vmalarczyk/airfoil_pcb/brass_manifold.STEP

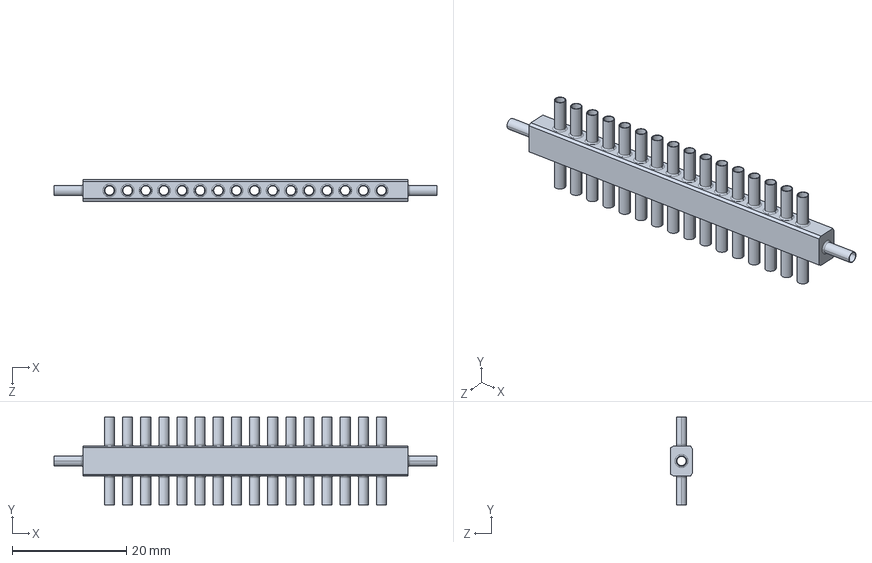
[picture p1: CAD file, 2024-07-12]
brass_manifold.STEP
67.1 x 15.4 x 3.81 mm
