vmalarczyk/airfoil_pcb/connector_component.STEP

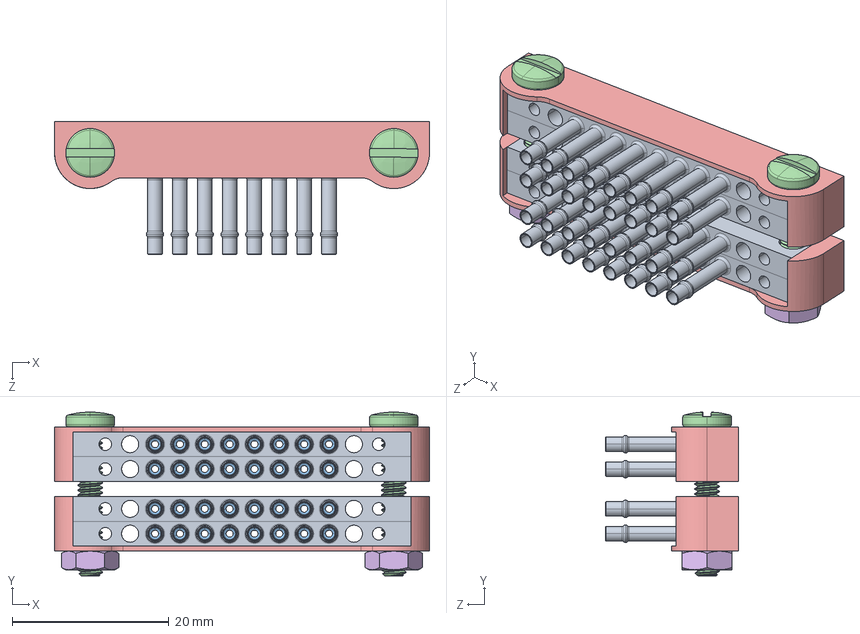
[picture p2: CAD file, 2024-07-12]
connector_component.STEP
47.9 x 20.9 x 16.9 mm
pneumatic_connector x 4
gasket_frame x 4
o_ring x 32
91792A131_18-8 Stainless Steel Pan Head Slotted Screws_91792A131 x 2
connector_holder x 2
90760A130_Steel Narrow Hex Nuts_90760A130 x 2
