vmalarczyk/airfoil_pcb/brass_manifold.pdf

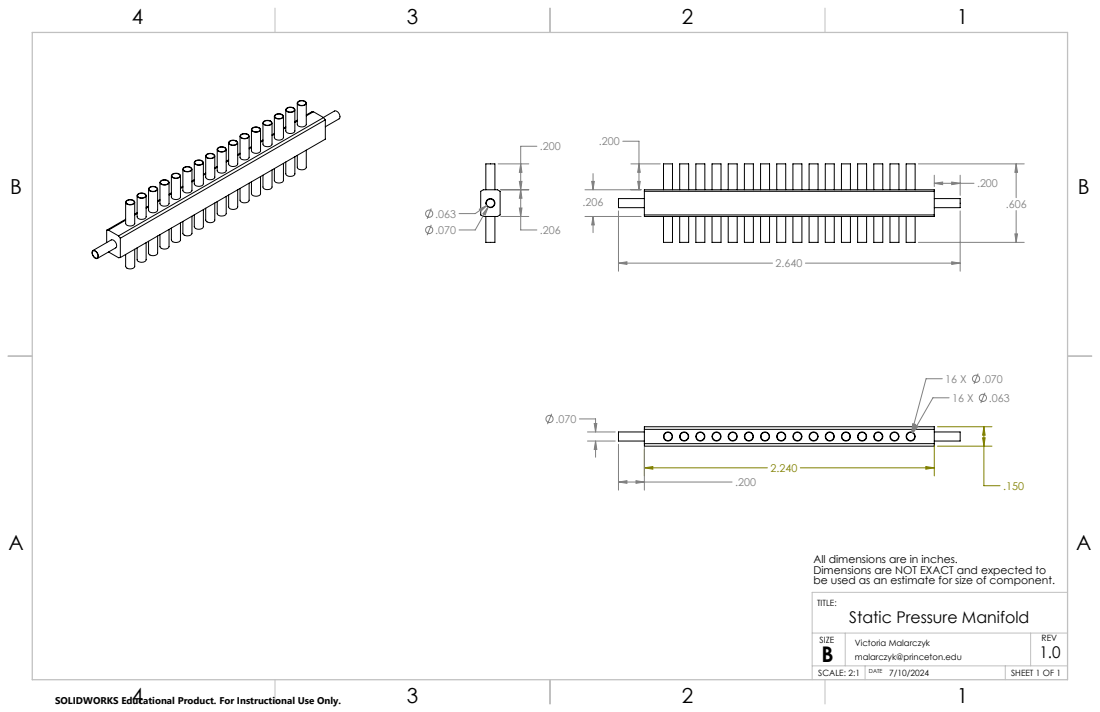
[picture p3: page 1]

All dimensions are in inches.
Dimensions are NOT EXACT and expected to
be used as an estimate for size of component.
Static Pressure Manifold

SIZE B | Victoria Malarczyk malarczyk@princeton.edu | REV 1.0

SCALE: 2:1 | DATE 7/10/2024 | SHEET 1 OF 1

SOLIDWORKS Educational Product. For Instructional Use Only.
