vmalarczyk/airfoil_pcb/tube_connector.pdf

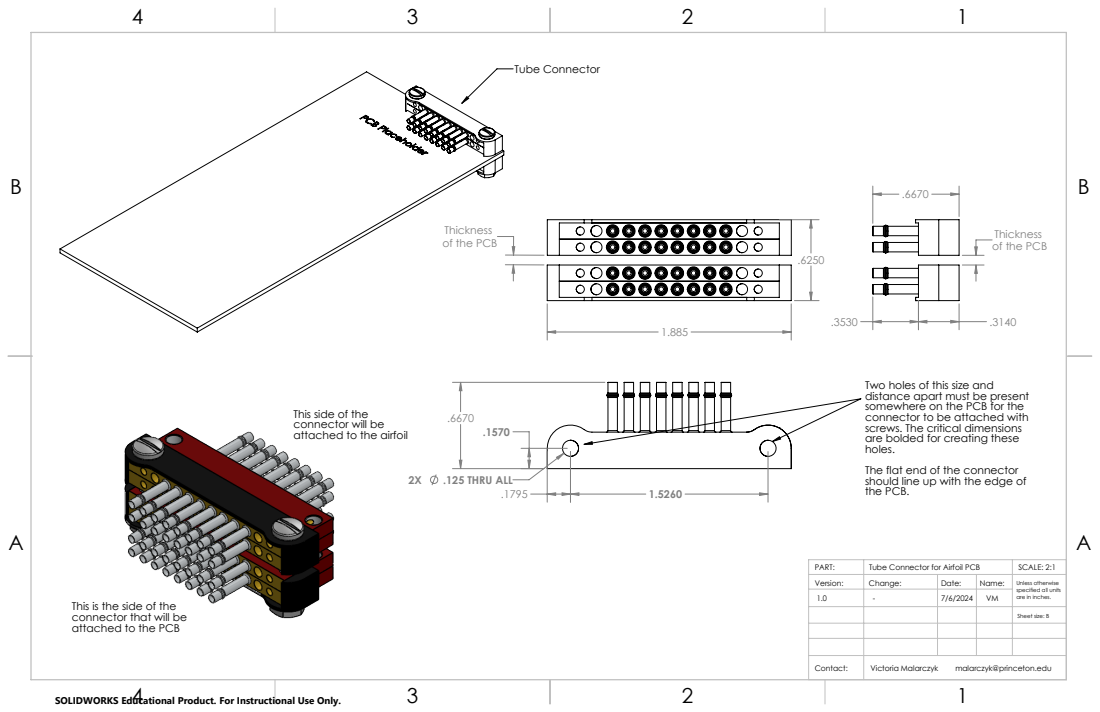
[picture p4: page 1]
Tube Connector; .125 THRU ALL; Contact:; Victoria Malarczyk; malarczyk@princeton.edu

Thickness
of the PCB

Two holes of this size and
distance apart must be present
somewhere on the PCB for the
connector to be attached with
screws. The critical dimensions
are bolded for creating these
holes.
The flat end of the connector
should line up with the edge of
the PCB.

This side of the
connector will be
attached to the airfoil

PART: | Tube Connector for Airfoil PCB | SCALE: 2:1

Version: | Change: | Date: | Name: | Unless otherwise specified all units are in inches.
1.0 | - | 7/6/2024 | VM

This is the side of the
connector that will be
attached to the PCB

Sheet size: B

SOLIDWORKS Educational Product. For Instructional Use Only.
