vmalarczyk/airfoil_pcb/air_foil_pcb/air_foil_pcb.pdf

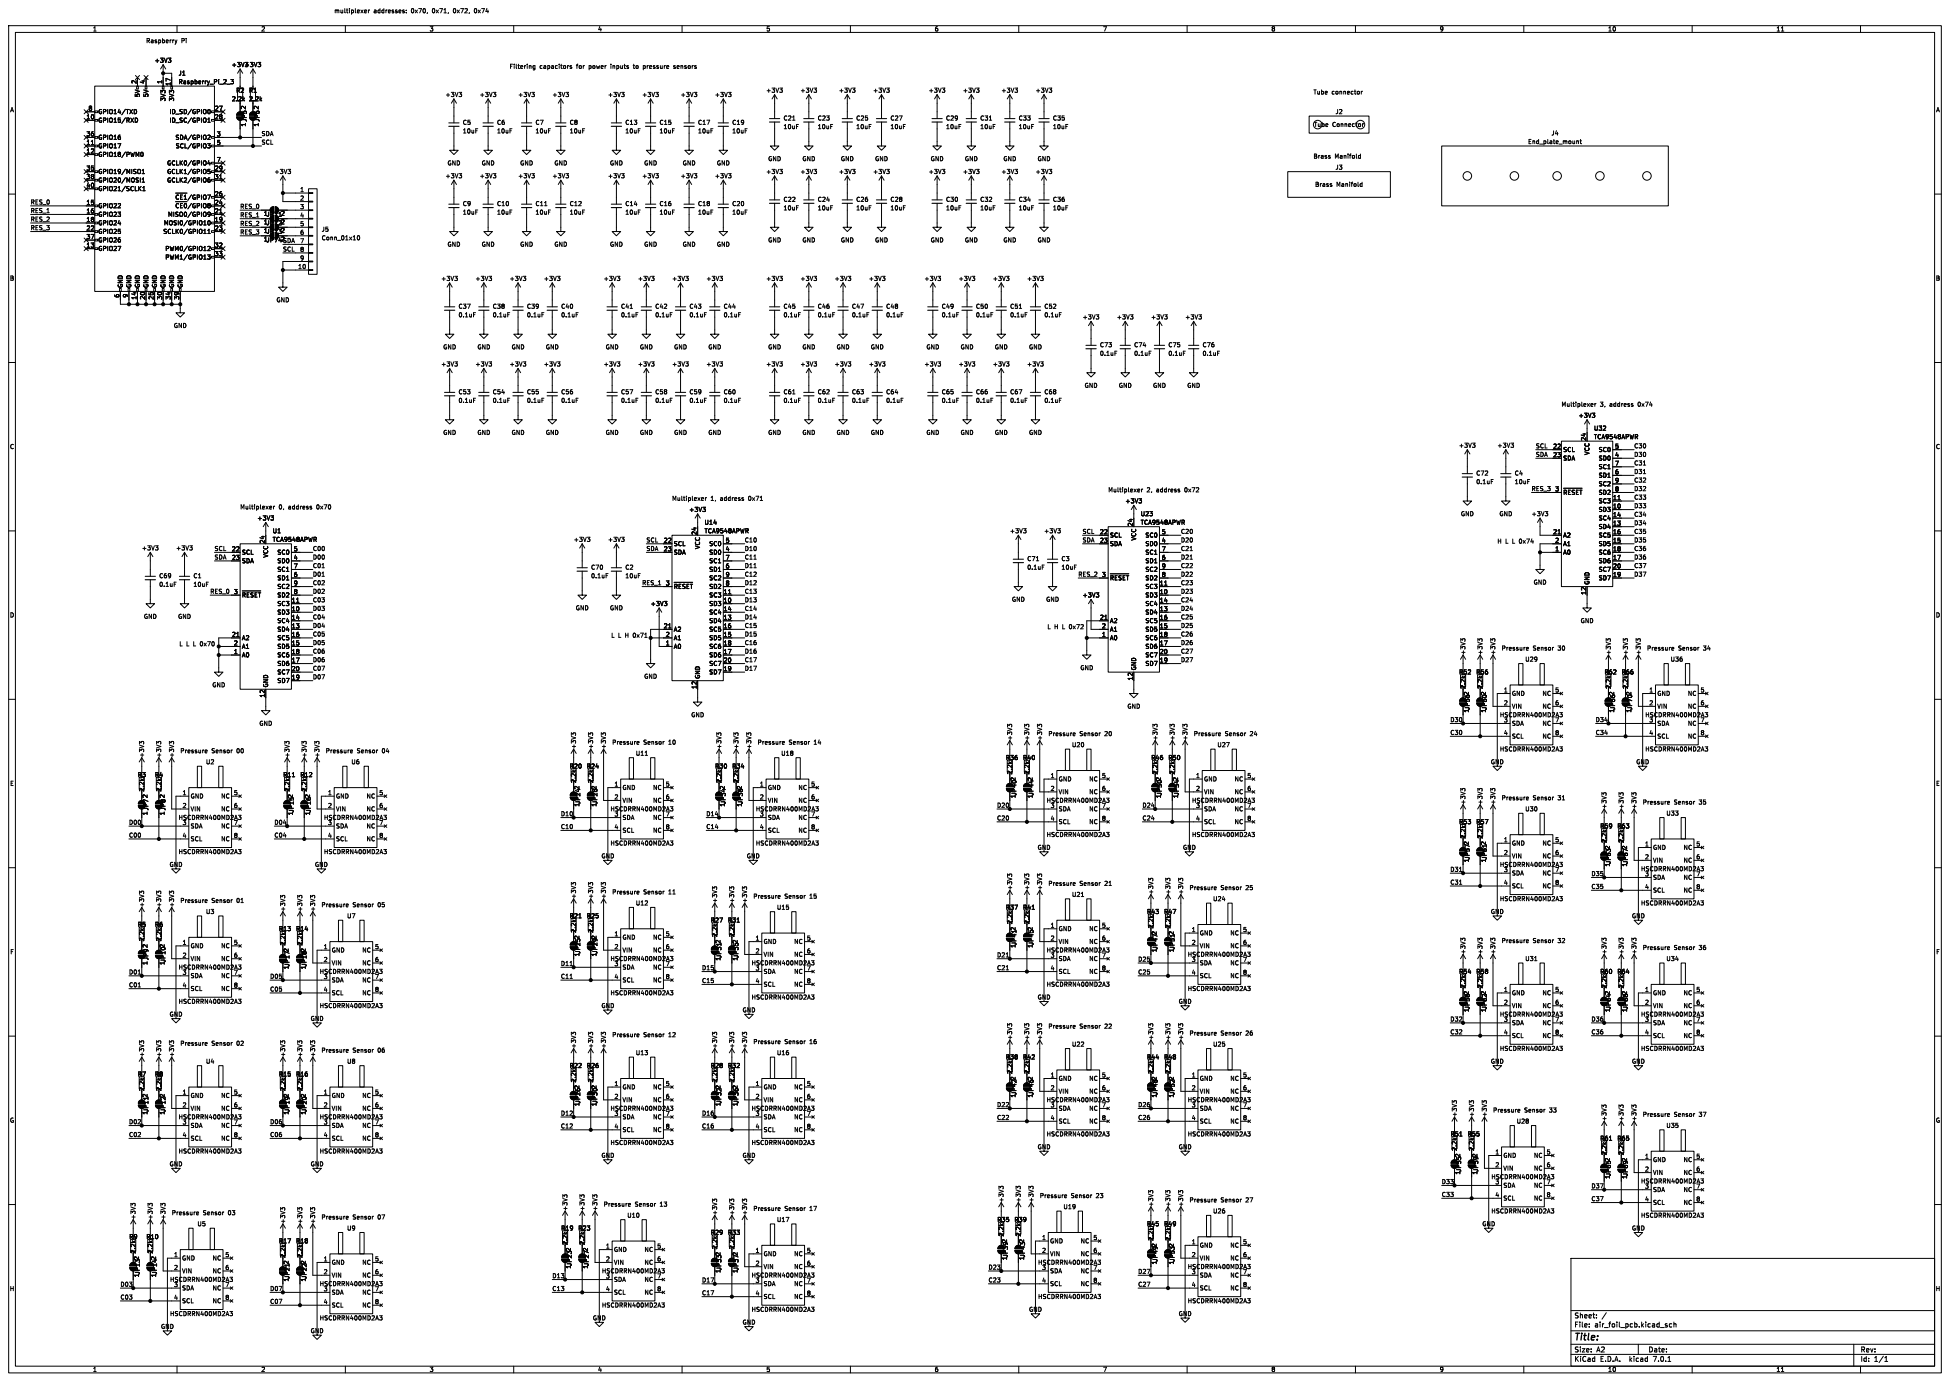
[picture p5: page 1]

+3V3 GND
Pressure Sensor 24 Pressure Sensor 25 Pressure Sensor 23

Pressure Sensor 00 Pressure Sensor 01 Pressure Sensor 02

Pressure Sensor 05 Pressure Sensor 07

Id: 1/1 Title: File: air_foil_pcb.kicad_sch Sheet: /
