vmalarczyk/airfoil_pcb/air_foil_schematic_0_1.pdf

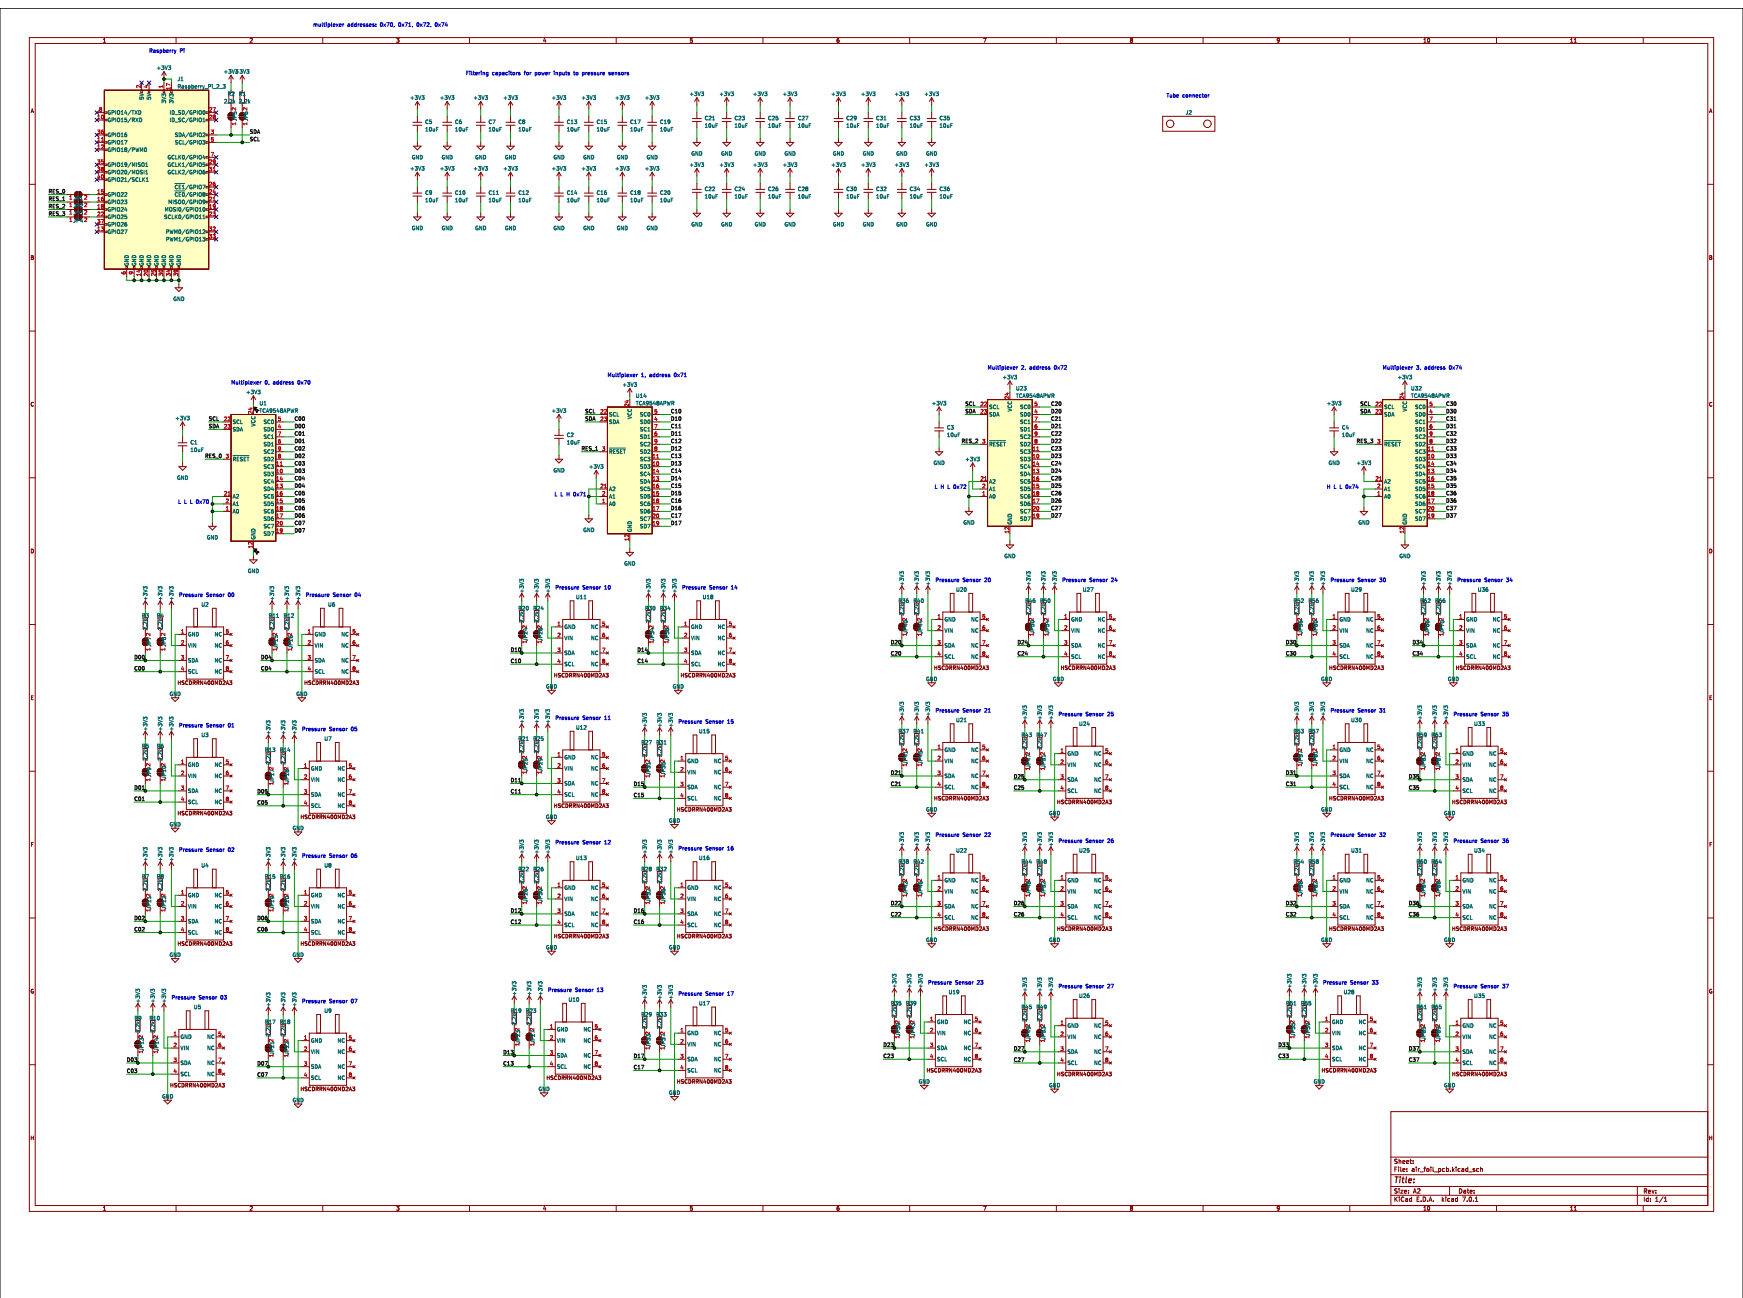
[picture p6: page 1]
