vmalarczyk/airfoil_pcb/air_foil_pcb/air_foil_pcb.kicad_pcb

## KiCad design air_foil_pcb/air_foil_pcb.kicad_pcb (2024-07-13)

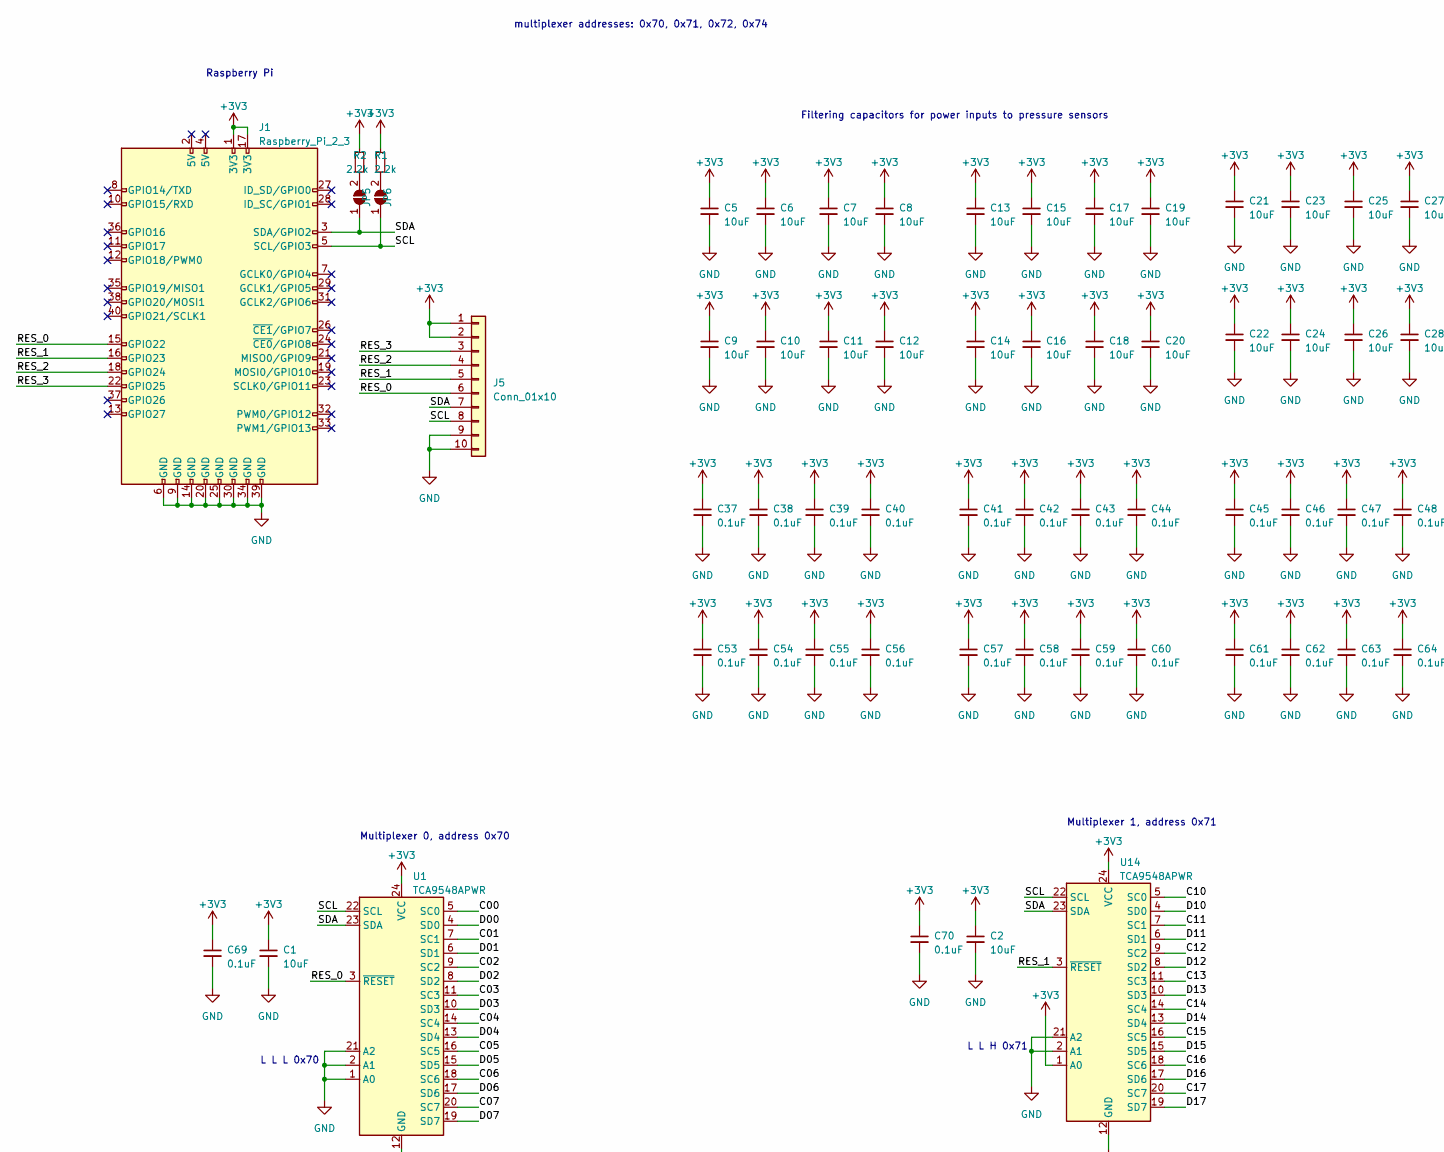
[picture p7: schematic air_foil_pcb.kicad_sch, part in row 1, column 1]

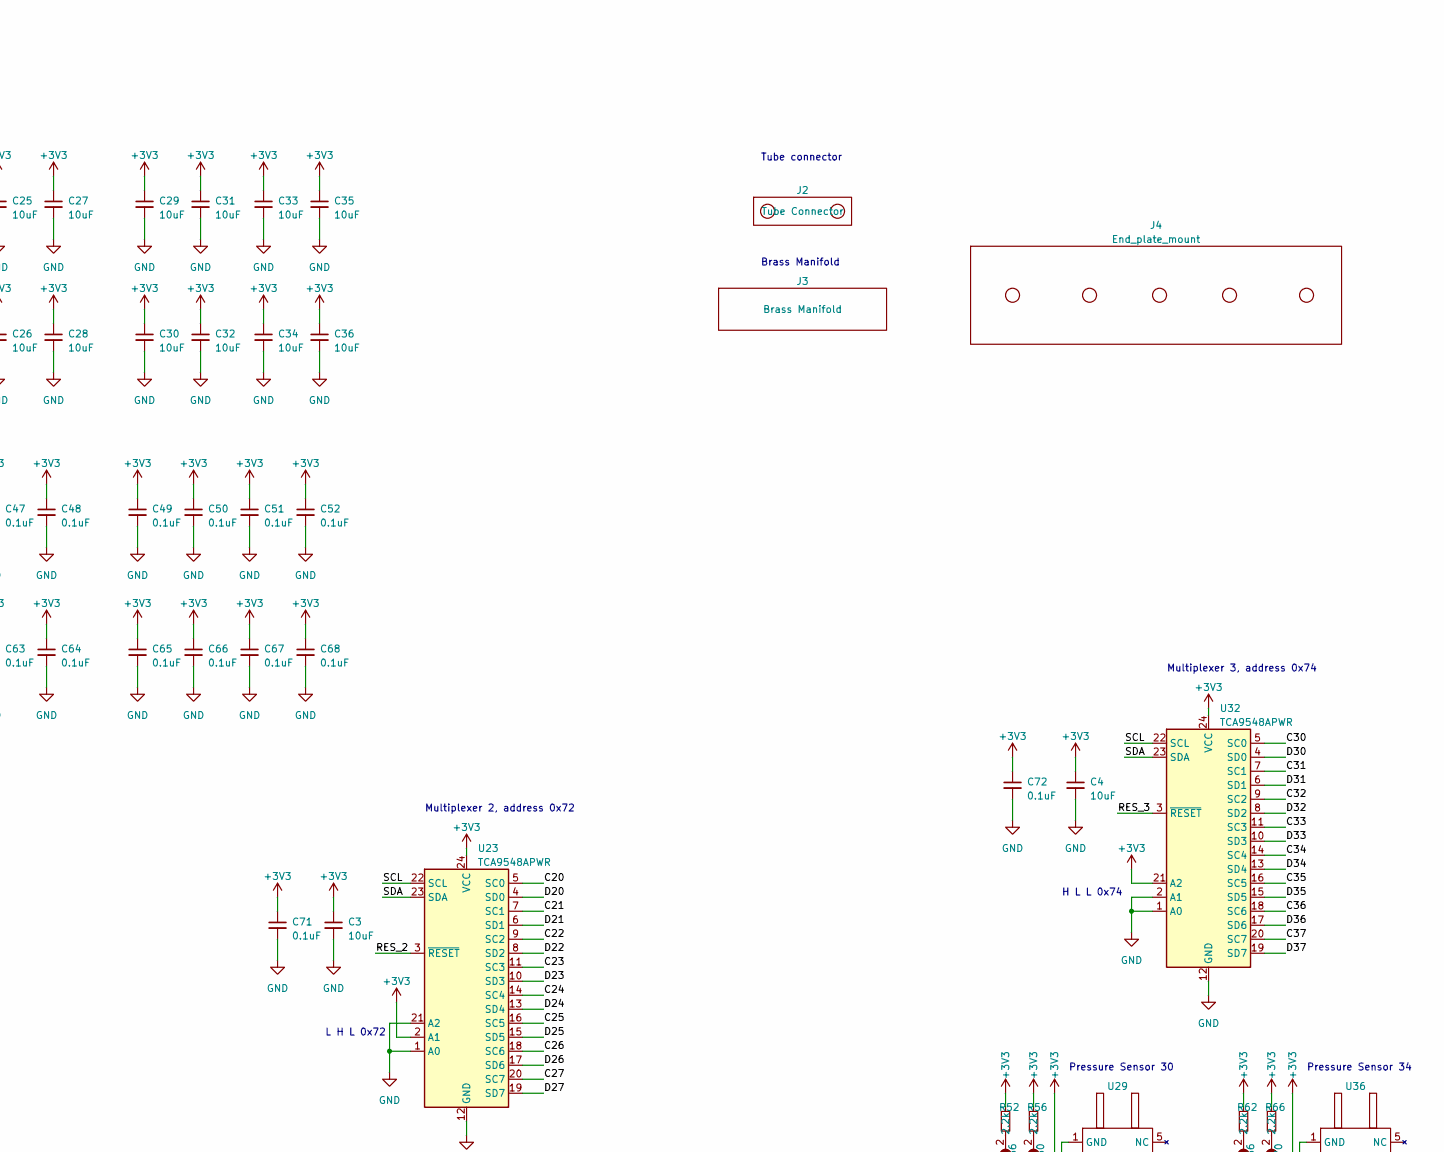
[picture p8: schematic air_foil_pcb.kicad_sch, part in row 1, column 2]

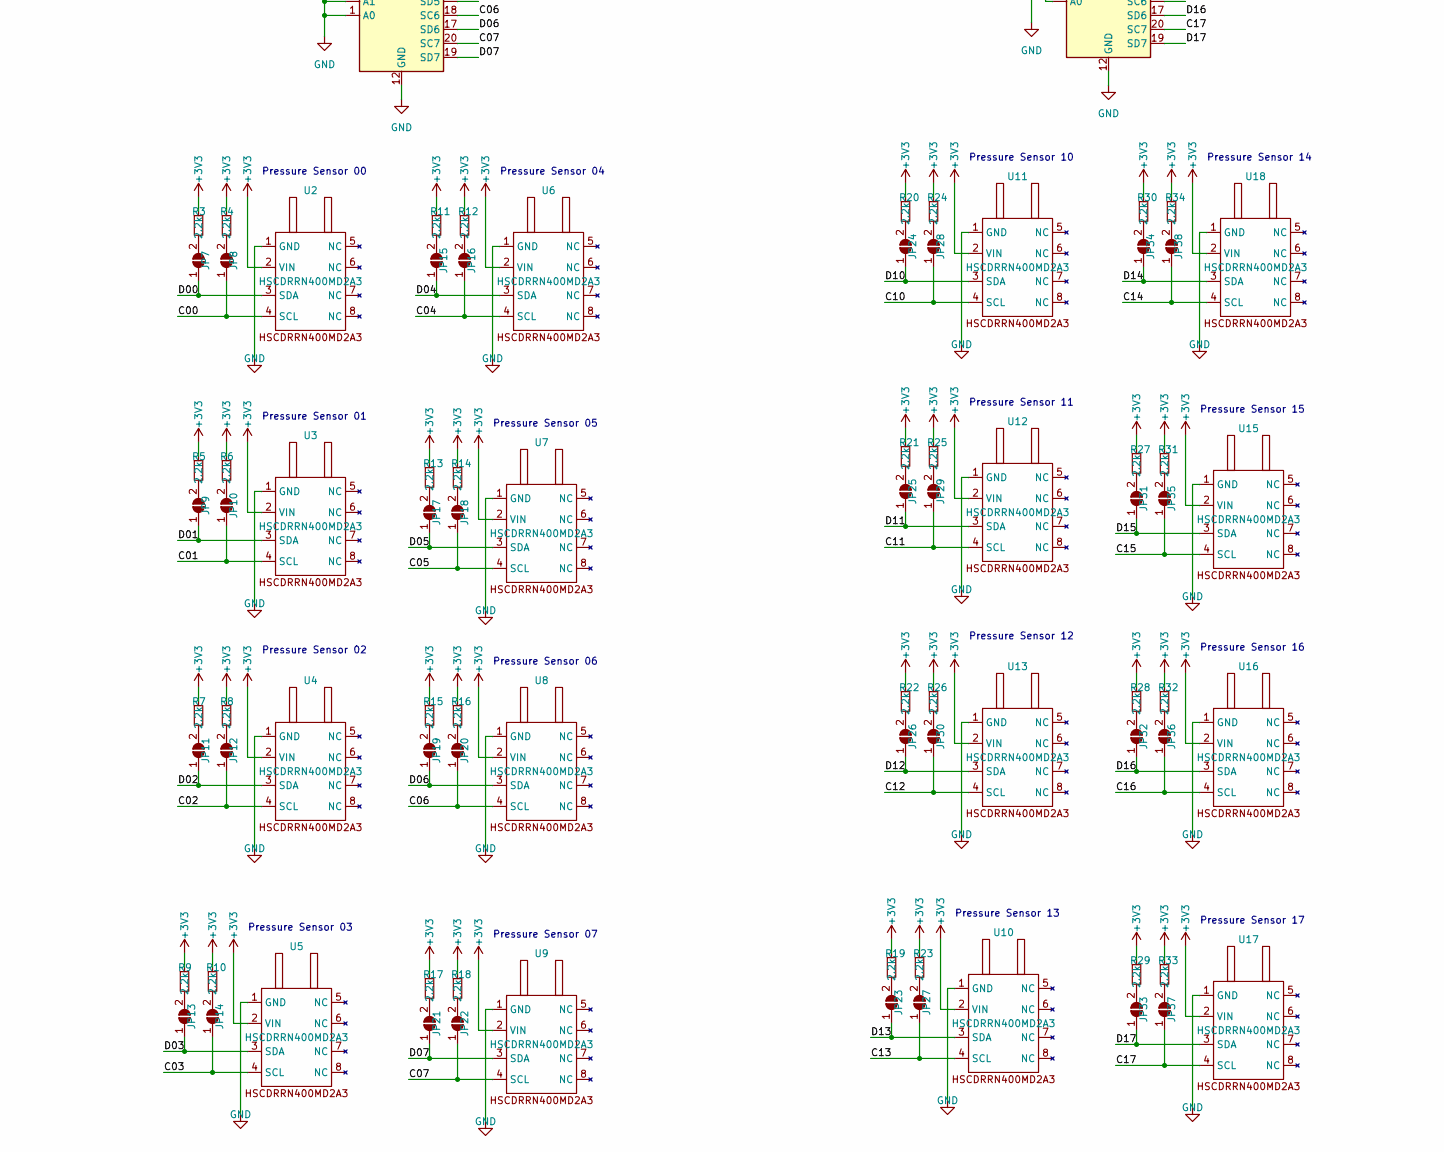
[picture p9: schematic air_foil_pcb.kicad_sch, part in row 2, column 1]

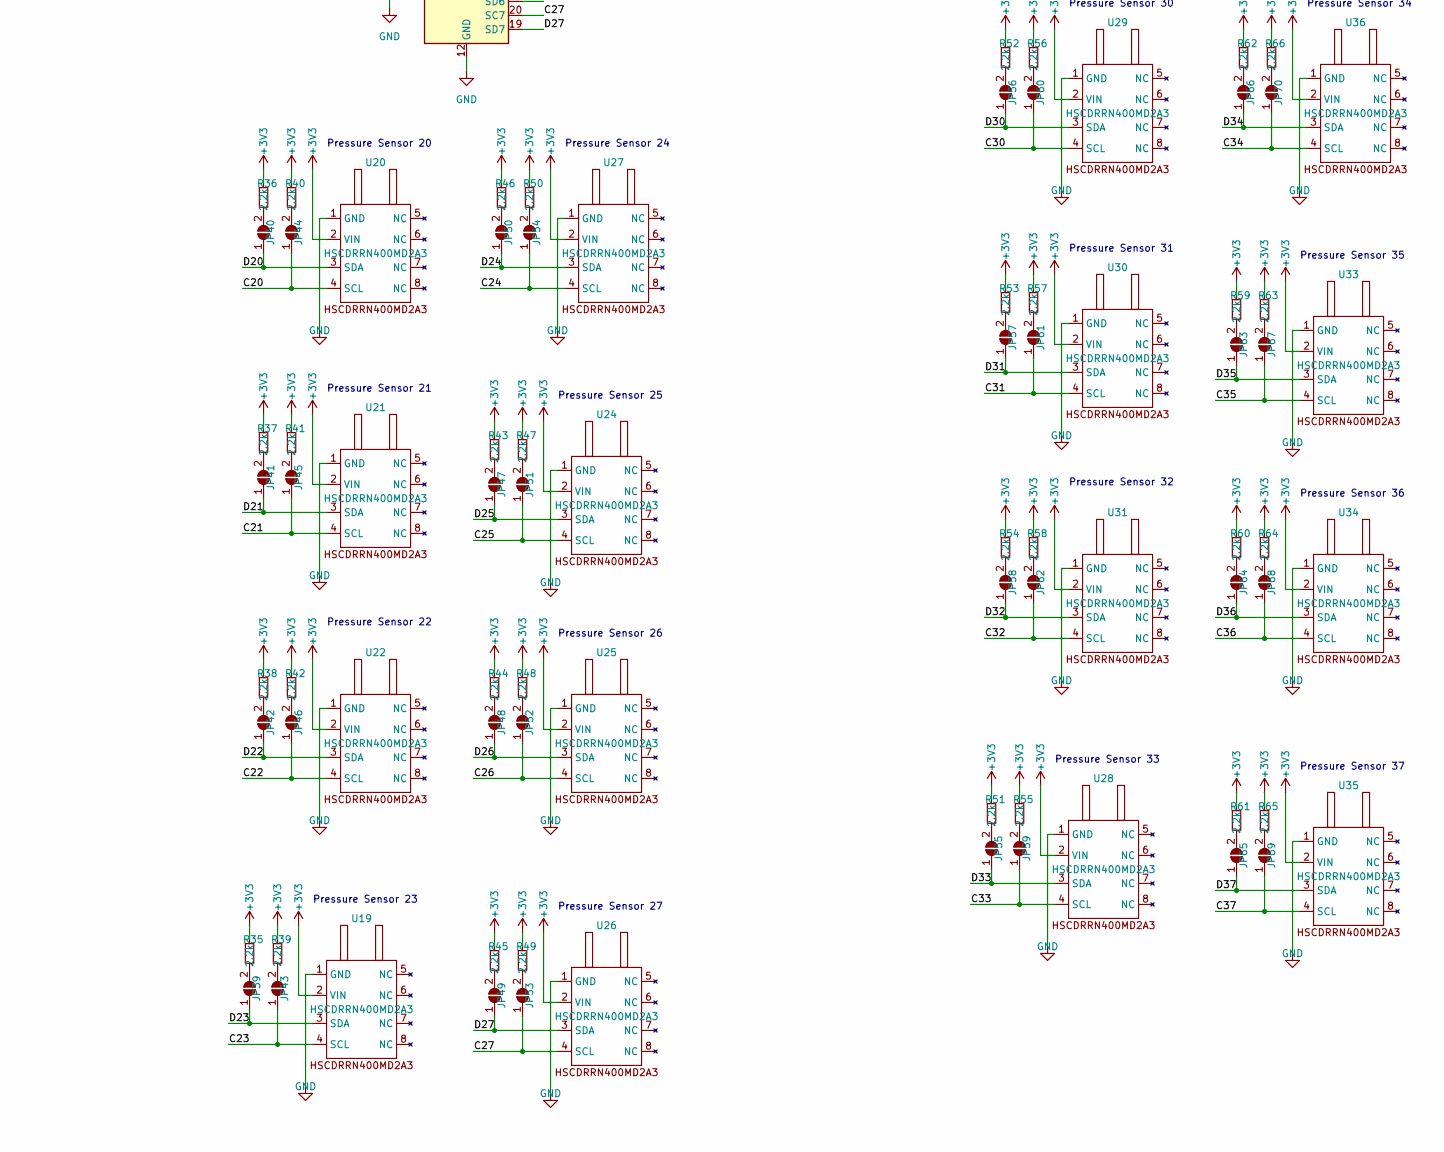
[picture p10: schematic air_foil_pcb.kicad_sch, part in row 2, column 2]

Parts:
C1, C2, C3, C4, C5, C6, C7, C8, C9, C10, C11, C12, C13, C14, C15, C16, C17, C18, C19, C20, C21, C22, C23, C24, C25, C26, C27, C28, C29, C30, C31, C32, C33, C34, C35, C36: 10uF; C_0201_0603Metric; JLCPCB_Part_num C96446
C37, C38, C39, C40, C41, C42, C43, C44, C45, C46, C47, C48, C49, C50, C51, C52, C53, C54, C55, C56, C57, C58, C59, C60, C61, C62, C63, C64, C65, C66, C67, C68, C69, C70, C71, C72: 0.1uF; C_0201_0603Metric; JLCPCB_Part_num C14663
J1: Raspberry_Pi_2_3
J2: Tube Connector; tube_connector
J3: Brass Manifold; static_pressure_manifold
J4: End_plate_mount; end_plate_connector
J5: Conn_01x10; PinHeader_1x10_P2.54mm_Horizontal; JLCPCB_Part_num C86750
JP5, JP6, JP7, JP8, JP9, JP10, JP11, JP12, JP13, JP14, JP15, JP16, JP17, JP18, JP19, JP20, JP21, JP22, JP23, JP24, JP25, JP26, JP27, JP28, JP29, JP30, JP31, JP32, JP33, JP34, JP35, JP36, JP37, JP38, JP39, JP40, JP41, JP42, JP43, JP44, JP45, JP46, JP47, JP48, JP49, JP50, JP51, JP52, JP53, JP54, JP55, JP56, JP57, JP58, JP59, JP60, JP61, JP62, JP63, JP64, JP65, JP66, JP67, JP68, JP69, JP70: SolderJumper_2_Open; SolderJumper-2_P1.3mm_Open_TrianglePad1.0x1.5mm
R1, R2, R3, R4, R5, R6, R7, R8, R9, R10, R11, R12, R13, R14, R15, R16, R17, R18, R19, R20, R21, R22, R23, R24, R25, R26, R27, R28, R29, R30, R31, R32, R33, R34, R35, R36, R37, R38, R39, R40, R41, R42, R43, R44, R45, R46, R47, R48, R49, R50, R51, R52, R53, R54, R55, R56, R57, R58, R59, R60, R61, R62, R63, R64, R65, R66: 2.2k; R_01005_0402Metric; JLCPCB_Part_num C25879
U1, U14, U23, U32: TCA9548APWR; TSSOP-24_4.4x7.8mm_P0.65mm; JLCPCB_Part_num C130026
U2, U3, U4, U5, U6, U7, U8, U9, U10, U11, U12, U13, U15, U16, U17, U18, U19, U20, U21, U22, U24, U25, U26, U27, U28, U29, U30, U31, U33, U34, U35, U36: HSCDRRN400MD2A3; hscdrrn400md2a3

Connections:
+3V3: C1.1, C2.1, C3.1, C4.1, C5.1, C6.1, C7.1, C8.1, C9.1, C10.1, C11.1, C12.1, C13.1, C14.1, C15.1, C16.1, C17.1, C18.1, C19.1, C20.1, C21.1, C22.1, C23.1, C24.1, C25.1, C26.1, C27.1, C28.1, C29.1, C30.1, C31.1, C32.1, C33.1, C34.1, C35.1, C36.1, C37.1, C38.1, C39.1, C40.1, C41.1, C42.1, C43.1, C44.1, C45.1, C46.1, C47.1, C48.1, C49.1, C50.1, C51.1, C52.1, C53.1, C54.1, C55.1, C56.1, C57.1, C58.1, C59.1, C60.1, C61.1, C62.1, C63.1, C64.1, C65.1, C66.1, C67.1, C68.1, C69.1, C70.1, C71.1, C72.1, J1.1 (3V3), J1.17 (3V3), J5.1, J5.2, R1.1, R2.1, R3.1, R4.1, R5.1, R6.1, R7.1, R8.1, R9.1, R10.1, R11.1, R12.1, R13.1, R14.1, R15.1, R16.1, R17.1, R18.1, R19.1, R20.1, R21.1, R22.1, R23.1, R24.1, R25.1, R26.1, R27.1, R28.1, R29.1, R30.1, R31.1, R32.1, R33.1, R34.1, R35.1, R36.1, R37.1, R38.1, R39.1, R40.1, R41.1, R42.1, R43.1, R44.1, R45.1, R46.1, R47.1, R48.1, R49.1, R50.1, R51.1, R52.1, R53.1, R54.1, R55.1, R56.1, R57.1, R58.1, R59.1, R60.1, R61.1, R62.1, R63.1, R64.1, R65.1, R66.1, U1.24 (VCC), U2.2 (VIN), U3.2 (VIN), U4.2 (VIN), U5.2 (VIN), U6.2 (VIN), U7.2 (VIN), U8.2 (VIN), U9.2 (VIN), U10.2 (VIN), U11.2 (VIN), U12.2 (VIN), U13.2 (VIN), U14.1 (A0), U14.24 (VCC), U15.2 (VIN), U16.2 (VIN), U17.2 (VIN), U18.2 (VIN), U19.2 (VIN), U20.2 (VIN), U21.2 (VIN), U22.2 (VIN), U23.2 (A1), U23.24 (VCC), U24.2 (VIN), U25.2 (VIN), U26.2 (VIN), U27.2 (VIN), U28.2 (VIN), U29.2 (VIN), U30.2 (VIN), U31.2 (VIN), U32.21 (A2), U32.24 (VCC), U33.2 (VIN), U34.2 (VIN), U35.2 (VIN), U36.2 (VIN)
/C00: JP8.1 (A), U1.5 (SC0), U2.4 (SCL)
/C01: JP10.1 (A), U1.7 (SC1), U3.4 (SCL)
/C02: JP12.1 (A), U1.9 (SC2), U4.4 (SCL)
/C03: JP14.1 (A), U1.11 (SC3), U5.4 (SCL)
/C04: JP16.1 (A), U1.14 (SC4), U6.4 (SCL)
/C05: JP18.1 (A), U1.16 (SC5), U7.4 (SCL)
/C06: JP20.1 (A), U1.18 (SC6), U8.4 (SCL)
/C07: JP22.1 (A), U1.20 (SC7), U9.4 (SCL)
/C10: JP28.1 (A), U11.4 (SCL), U14.5 (SC0)
/C11: JP29.1 (A), U12.4 (SCL), U14.7 (SC1)
/C12: JP30.1 (A), U13.4 (SCL), U14.9 (SC2)
/C13: JP27.1 (A), U10.4 (SCL), U14.11 (SC3)
/C14: JP38.1 (A), U14.14 (SC4), U18.4 (SCL)
/C15: JP35.1 (A), U14.16 (SC5), U15.4 (SCL)
/C16: JP36.1 (A), U14.18 (SC6), U16.4 (SCL)
/C17: JP37.1 (A), U14.20 (SC7), U17.4 (SCL)
/C20: JP44.1 (A), U20.4 (SCL), U23.5 (SC0)
/C21: JP45.1 (A), U21.4 (SCL), U23.7 (SC1)
/C22: JP46.1 (A), U22.4 (SCL), U23.9 (SC2)
/C23: JP43.1 (A), U19.4 (SCL), U23.11 (SC3)
/C24: JP54.1 (A), U23.14 (SC4), U27.4 (SCL)
/C25: JP51.1 (A), U23.16 (SC5), U24.4 (SCL)
/C26: JP52.1 (A), U23.18 (SC6), U25.4 (SCL)
/C27: JP53.1 (A), U23.20 (SC7), U26.4 (SCL)
/C30: JP60.1 (A), U29.4 (SCL), U32.5 (SC0)
/C31: JP61.1 (A), U30.4 (SCL), U32.7 (SC1)
/C32: JP62.1 (A), U31.4 (SCL), U32.9 (SC2)
/C33: JP59.1 (A), U28.4 (SCL), U32.11 (SC3)
/C34: JP70.1 (A), U32.14 (SC4), U36.4 (SCL)
/C35: JP67.1 (A), U32.16 (SC5), U33.4 (SCL)
/C36: JP68.1 (A), U32.18 (SC6), U34.4 (SCL)
/C37: JP69.1 (A), U32.20 (SC7), U35.4 (SCL)
/D00: JP7.1 (A), U1.4 (SD0), U2.3 (SDA)
/D01: JP9.1 (A), U1.6 (SD1), U3.3 (SDA)
/D02: JP11.1 (A), U1.8 (SD2), U4.3 (SDA)
/D03: JP13.1 (A), U1.10 (SD3), U5.3 (SDA)
/D04: JP15.1 (A), U1.13 (SD4), U6.3 (SDA)
/D05: JP17.1 (A), U1.15 (SD5), U7.3 (SDA)
/D06: JP19.1 (A), U1.17 (SD6), U8.3 (SDA)
/D07: JP21.1 (A), U1.19 (SD7), U9.3 (SDA)
/D10: JP24.1 (A), U11.3 (SDA), U14.4 (SD0)
/D11: JP25.1 (A), U12.3 (SDA), U14.6 (SD1)
/D12: JP26.1 (A), U13.3 (SDA), U14.8 (SD2)
/D13: JP23.1 (A), U10.3 (SDA), U14.10 (SD3)
/D14: JP34.1 (A), U14.13 (SD4), U18.3 (SDA)
/D15: JP31.1 (A), U14.15 (SD5), U15.3 (SDA)
/D16: JP32.1 (A), U14.17 (SD6), U16.3 (SDA)
/D17: JP33.1 (A), U14.19 (SD7), U17.3 (SDA)
/D20: JP40.1 (A), U20.3 (SDA), U23.4 (SD0)
/D21: JP41.1 (A), U21.3 (SDA), U23.6 (SD1)
/D22: JP42.1 (A), U22.3 (SDA), U23.8 (SD2)
/D23: JP39.1 (A), U19.3 (SDA), U23.10 (SD3)
/D24: JP50.1 (A), U23.13 (SD4), U27.3 (SDA)
/D25: JP47.1 (A), U23.15 (SD5), U24.3 (SDA)
/D26: JP48.1 (A), U23.17 (SD6), U25.3 (SDA)
/D27: JP49.1 (A), U23.19 (SD7), U26.3 (SDA)
/D30: JP56.1 (A), U29.3 (SDA), U32.4 (SD0)
/D31: JP57.1 (A), U30.3 (SDA), U32.6 (SD1)
/D32: JP58.1 (A), U31.3 (SDA), U32.8 (SD2)
/D33: JP55.1 (A), U28.3 (SDA), U32.10 (SD3)
/D34: JP66.1 (A), U32.13 (SD4), U36.3 (SDA)
/D35: JP63.1 (A), U32.15 (SD5), U33.3 (SDA)
/D36: JP64.1 (A), U32.17 (SD6), U34.3 (SDA)
/D37: JP65.1 (A), U32.19 (SD7), U35.3 (SDA)
/RES_0: J1.15 (GPIO22), J5.6, U1.3 (~RESET)
/RES_1: J1.16 (GPIO23), J5.5, U14.3 (~RESET)
/RES_2: J1.18 (GPIO24), J5.4, U23.3 (~RESET)
/RES_3: J1.22 (GPIO25), J5.3, U32.3 (~RESET)
/SCL: J1.5 (SCL/GPIO3), J5.8, JP6.1 (A), U1.22 (SCL), U14.22 (SCL), U23.22 (SCL), U32.22 (SCL)
/SDA: J1.3 (SDA/GPIO2), J5.7, JP5.1 (A), U1.23 (SDA), U14.23 (SDA), U23.23 (SDA), U32.23 (SDA)
GND: C1.2, C2.2, C3.2, C4.2, C5.2, C6.2, C7.2, C8.2, C9.2, C10.2, C11.2, C12.2, C13.2, C14.2, C15.2, C16.2, C17.2, C18.2, C19.2, C20.2, C21.2, C22.2, C23.2, C24.2, C25.2, C26.2, C27.2, C28.2, C29.2, C30.2, C31.2, C32.2, C33.2, C34.2, C35.2, C36.2, C37.2, C38.2, C39.2, C40.2, C41.2, C42.2, C43.2, C44.2, C45.2, C46.2, C47.2, C48.2, C49.2, C50.2, C51.2, C52.2, C53.2, C54.2, C55.2, C56.2, C57.2, C58.2, C59.2, C60.2, C61.2, C62.2, C63.2, C64.2, C65.2, C66.2, C67.2, C68.2, C69.2, C70.2, C71.2, C72.2, J1.6 (GND), J1.9 (GND), J1.14 (GND), J1.20 (GND), J1.25 (GND), J1.30 (GND), J1.34 (GND), J1.39 (GND), J5.9, J5.10, U1.1 (A0), U1.2 (A1), U1.12 (GND), U1.21 (A2), U2.1 (GND), U3.1 (GND), U4.1 (GND), U5.1 (GND), U6.1 (GND), U7.1 (GND), U8.1 (GND), U9.1 (GND), U10.1 (GND), U11.1 (GND), U12.1 (GND), U13.1 (GND), U14.2 (A1), U14.12 (GND), U14.21 (A2), U15.1 (GND), U16.1 (GND), U17.1 (GND), U18.1 (GND), U19.1 (GND), U20.1 (GND), U21.1 (GND), U22.1 (GND), U23.1 (A0), U23.12 (GND), U23.21 (A2), U24.1 (GND), U25.1 (GND), U26.1 (GND), U27.1 (GND), U28.1 (GND), U29.1 (GND), U30.1 (GND), U31.1 (GND), U32.1 (A0), U32.2 (A1), U32.12 (GND), U33.1 (GND), U34.1 (GND), U35.1 (GND), U36.1 (GND)
unnamed: JP5.2 (B), R2.2
unnamed: JP6.2 (B), R1.2
unnamed: JP7.2 (B), R3.2
unnamed: JP8.2 (B), R4.2
unnamed: JP9.2 (B), R5.2
unnamed: JP10.2 (B), R6.2
unnamed: JP11.2 (B), R7.2
unnamed: JP12.2 (B), R8.2
unnamed: JP13.2 (B), R9.2
unnamed: JP14.2 (B), R10.2
unnamed: JP15.2 (B), R11.2
unnamed: JP16.2 (B), R12.2
unnamed: JP17.2 (B), R13.2
unnamed: JP18.2 (B), R14.2
unnamed: JP19.2 (B), R15.2
unnamed: JP20.2 (B), R16.2
unnamed: JP21.2 (B), R17.2
unnamed: JP22.2 (B), R18.2
unnamed: JP23.2 (B), R19.2
unnamed: JP24.2 (B), R20.2
unnamed: JP25.2 (B), R21.2
unnamed: JP26.2 (B), R22.2
unnamed: JP27.2 (B), R23.2
unnamed: JP28.2 (B), R24.2
unnamed: JP29.2 (B), R25.2
unnamed: JP30.2 (B), R26.2
unnamed: JP31.2 (B), R27.2
unnamed: JP32.2 (B), R28.2
unnamed: JP33.2 (B), R29.2
unnamed: JP34.2 (B), R30.2
unnamed: JP35.2 (B), R31.2
unnamed: JP36.2 (B), R32.2
unnamed: JP37.2 (B), R33.2
unnamed: JP38.2 (B), R34.2
unnamed: JP39.2 (B), R35.2
unnamed: JP40.2 (B), R36.2
unnamed: JP41.2 (B), R37.2
unnamed: JP42.2 (B), R38.2
unnamed: JP43.2 (B), R39.2
unnamed: JP44.2 (B), R40.2
unnamed: JP45.2 (B), R41.2
unnamed: JP46.2 (B), R42.2
unnamed: JP47.2 (B), R43.2
unnamed: JP48.2 (B), R44.2
unnamed: JP49.2 (B), R45.2
unnamed: JP50.2 (B), R46.2
unnamed: JP51.2 (B), R47.2
unnamed: JP52.2 (B), R48.2
unnamed: JP53.2 (B), R49.2
unnamed: JP54.2 (B), R50.2
unnamed: JP55.2 (B), R51.2
unnamed: JP56.2 (B), R52.2
unnamed: JP57.2 (B), R53.2
unnamed: JP58.2 (B), R54.2
unnamed: JP59.2 (B), R55.2
unnamed: JP60.2 (B), R56.2
unnamed: JP61.2 (B), R57.2
unnamed: JP62.2 (B), R58.2
unnamed: JP63.2 (B), R59.2
unnamed: JP64.2 (B), R60.2
unnamed: JP65.2 (B), R61.2
unnamed: JP66.2 (B), R62.2
unnamed: JP67.2 (B), R63.2
unnamed: JP68.2 (B), R64.2
unnamed: JP69.2 (B), R65.2
unnamed: JP70.2 (B), R66.2

Notes on the sheet:
Multiplexer 3, address 0x74
Pressure Sensor 13
Brass Manifold
Pressure Sensor 27
Pressure Sensor 32
L H L 0x72
Pressure Sensor 04
multiplexer addresses: 0x70, 0x71, 0x72, 0x74
Pressure Sensor 24
H L L 0x74
Pressure Sensor 07
Pressure Sensor 15
Pressure Sensor 06
Pressure Sensor 25
Pressure Sensor 23
Pressure Sensor 33
Filtering capacitors for power inputs to pressure sensors
Tube connector
Pressure Sensor 11
Pressure Sensor 20
Pressure Sensor 31
Pressure Sensor 03
Pressure Sensor 00
Pressure Sensor 01
Pressure Sensor 10
Raspberry Pi
Pressure Sensor 16
Pressure Sensor 14
Pressure Sensor 36
Pressure Sensor 12
Pressure Sensor 30
L L L 0x70
Pressure Sensor 34
Pressure Sensor 05
Pressure Sensor 37
Multiplexer 1, address 0x71
Pressure Sensor 22
L L H 0x71
Pressure Sensor 35
Multiplexer 2, address 0x72
Pressure Sensor 26
Pressure Sensor 21
Pressure Sensor 02
Multiplexer 0, address 0x70
Pressure Sensor 17

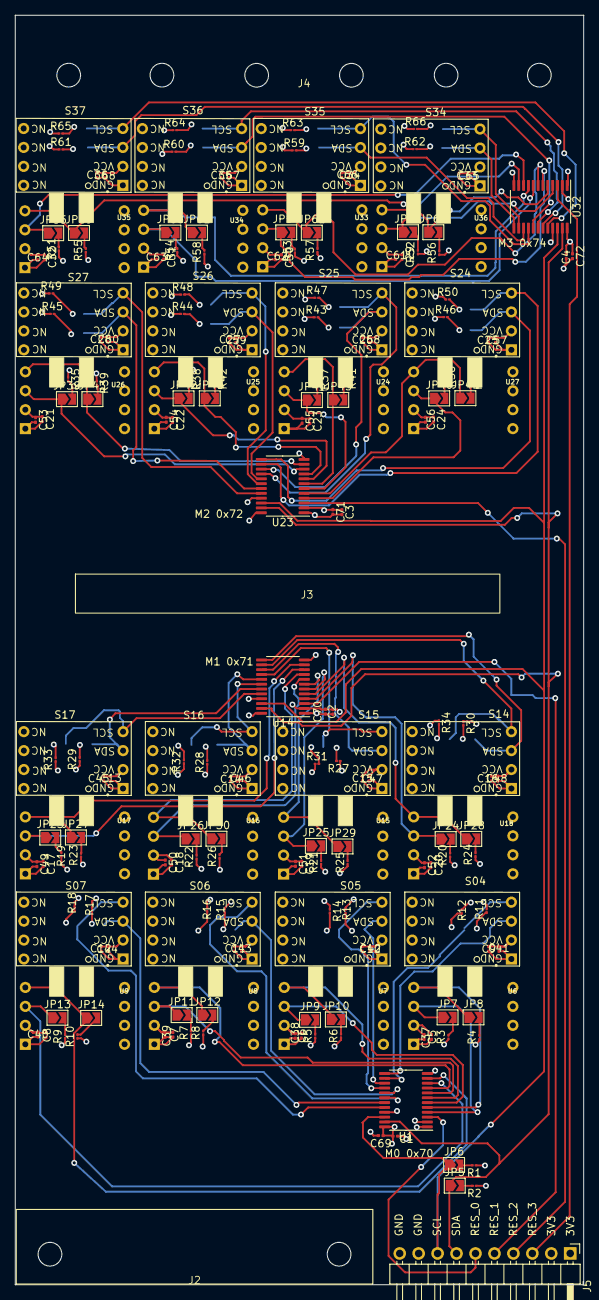
[picture p11: board air_foil_pcb.kicad_pcb from above]

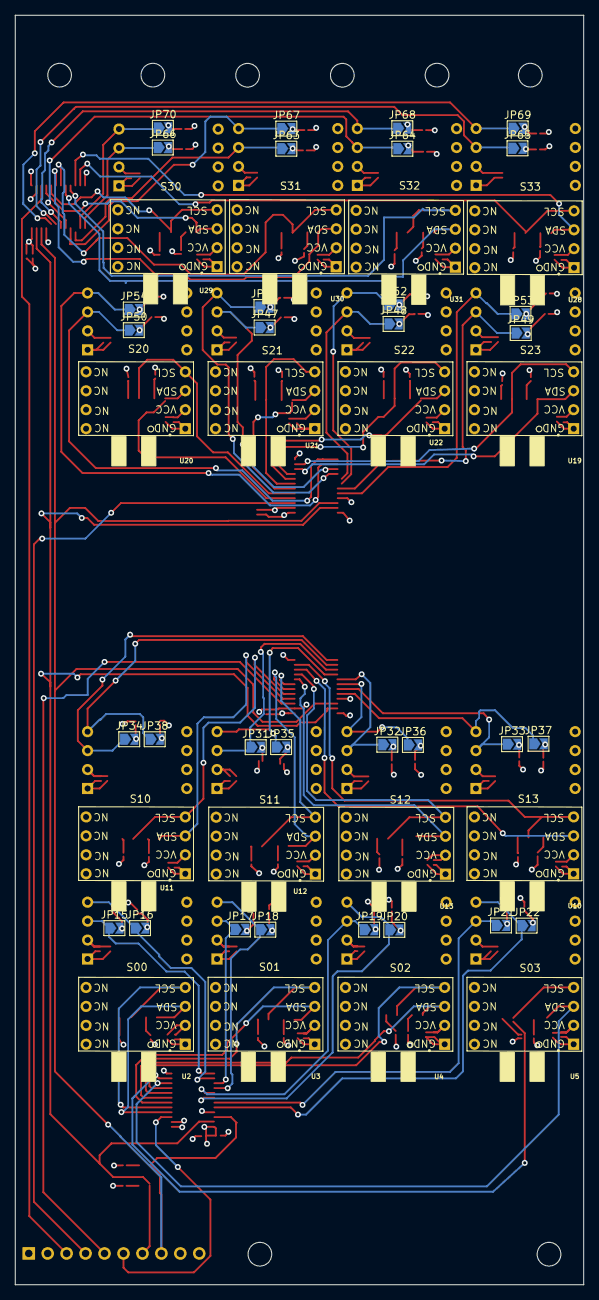
[picture p12: board air_foil_pcb.kicad_pcb from below]

Board: 4 copper layers, 76.2 x 170.2 mm, 244 parts (48 on the bottom side), 138 nets.
