vmalarczyk/airfoil_pcb/(commit log)

2024-07-06 created schematic for HSC pressure sensor, started work on main schematic
    [air_foil_pcb.kicad_sch]
2024-07-07 made adjustment to pressure sensor schematic, schematic for first multiplexer and associated sensor completed
    [air_foil_pcb.kicad_sch]
2024-07-07 finished schematic, added tube connector
    [air_foil_pcb.kicad_sch]
2024-07-07 added 0.1uF caps to power inputs for high frequency filtering
    [air_foil_pcb.kicad_sch]
2024-07-12 working on schematic
    [air_foil_pcb.kicad_pcb, air_foil_pcb.kicad_sch, brass_manifold.STEP, connector_component.STEP]
2024-07-12 finished layout
    [air_foil_pcb.kicad_pcb]
2024-07-13 fab files created
    [air_foil_pcb-B_Cu.gbl, air_foil_pcb-B_Mask.gbs, air_foil_pcb-B_Paste.gbp, air_foil_pcb-B_Silkscreen.gbo, air_foil_pcb-Edge_Cuts.gm1, air_foil_pcb-F_Cu.gtl, air_foil_pcb-F_Mask.gts, air_foil_pcb-F_Paste.gtp]
2024-07-13 added jlcpcb production folder, modified rotations for production file
    [BOM-air_foil_pcb.csv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]
